freeDSP/freeDSP-aurora/ADDONS/AddOnB/KICAD/Board B/AddOnB.kicad_pcb

## KiCad design ADDONS/AddOnB/KICAD/Board B/AddOnB.kicad_pcb (2019-11-06)

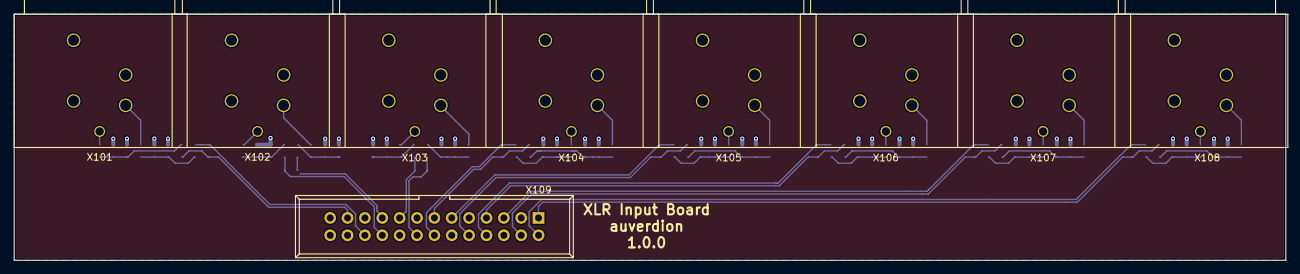
[picture p1: board ADDONS/AddOnB/KICAD/Board B/AddOnB.kicad_pcb from above]

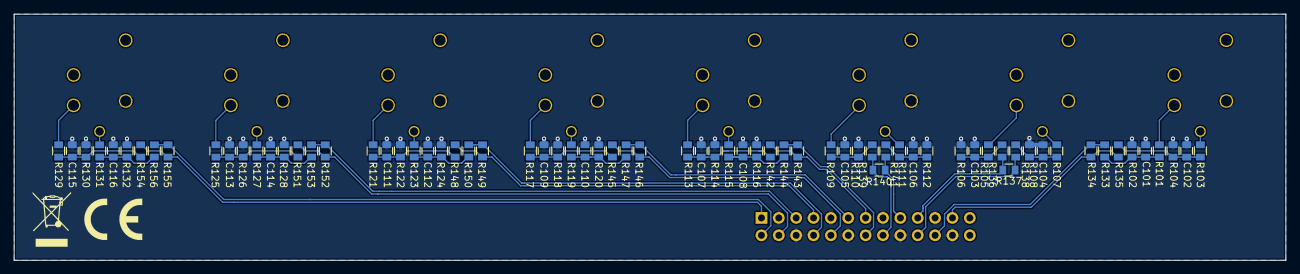
[picture p2: board ADDONS/AddOnB/KICAD/Board B/AddOnB.kicad_pcb from below]

Board: 2 copper layers, 186.0 x 36.0 mm, 81 parts (72 on the bottom side), 49 nets.

Parts:
C101, C102, C103, C104, C105, C106, C107, C108, C109, C110, C111, C112, C113, C114, C115, C116: CAP_100p_50V_C0G_NP0_0805; C0805-X7R
R101, R103, R105, R107, R109, R111, R113, R115, R117, R119, R121, R123, R125, R127, R129, R131: RES_100R_1%_0.25W_Thin_0805; C0805-RES
R102, R104, R106, R108, R110, R112, R114, R116, R118, R120, R122, R124, R126, R128, R130, R132: RES_100K_1%_0.125W_Thick_0805; C0805-RES
R133, R135, R136, R138, R139, R141, R142, R144, R145, R147, R148, R150, R151, R153, R154, R156: RES_7K87_0.5%_0.100W_Thin_0805; C0805-RES
R134, R137, R140, R143, R146, R149, R152, R155: RES_5K11_0.5%_0.100W_Thin_0805; C0805-RES
X101, X102, X103, X104, X105, X106, X107, X108: XLR3; NC3FAH
X109: CON_IDC26; IDC26

Connections:
/AIN1+: R133.2, R134.2, X109.22
/AIN1-: R134.1, R135.2, X109.23
/AIN2+: R136.2, R137.2, X109.19
/AIN2-: R137.1, R138.2, X109.20
/AIN3+: R139.2, R140.2, X109.16
/AIN3-: R140.1, R141.2, X109.17
/AIN4+: R142.2, R143.2, X109.13
/AIN4-: R143.1, R144.2, X109.14
/AIN5+: R145.2, R146.2, X109.10
/AIN5-: R146.1, R147.2, X109.11
/AIN6+: R148.2, R149.2, X109.7
/AIN6-: R149.1, R150.2, X109.8
/AIN7+: R151.2, R152.2, X109.4
/AIN7-: R152.1, R153.2, X109.5
/AIN8+: R154.2, R155.2, X109.1
/AIN8-: R155.1, R156.2, X109.2
GND: C101.2, C102.2, C103.2, C104.2, C105.2, C106.2, C107.2, C108.2, C109.2, C110.2, C111.2, C112.2, C113.2, C114.2, C115.2, C116.2, R102.1, R104.1, R106.1, R108.1, R110.1, R112.1, R114.1, R116.1, R118.1, R120.1, R122.1, R124.1, R126.1, R128.1, R130.1, R132.1, X101.1, X102.1, X103.1, X104.1, X105.1, X106.1, X107.1, X108.1, X109.3, X109.6, X109.9, X109.12, X109.15, X109.18, X109.21, X109.24
unnamed: C101.1, R101.2, R102.2, R133.1
unnamed: C102.1, R103.2, R104.2, R135.1
unnamed: C103.1, R105.2, R106.2, R136.1
unnamed: C104.1, R107.2, R108.2, R138.1
unnamed: C105.1, R109.2, R110.2, R139.1
unnamed: C106.1, R111.2, R112.2, R141.1
unnamed: C107.1, R113.2, R114.2, R142.1
unnamed: C108.1, R115.2, R116.2, R144.1
unnamed: C109.1, R117.2, R118.2, R145.1
unnamed: C110.1, R119.2, R120.2, R147.1
unnamed: C111.1, R121.2, R122.2, R148.1
unnamed: C112.1, R123.2, R124.2, R150.1
unnamed: C113.1, R125.2, R126.2, R151.1
unnamed: C114.1, R127.2, R128.2, R153.1
unnamed: C115.1, R129.2, R130.2, R154.1
unnamed: C116.1, R131.2, R132.2, R156.1
unnamed: R101.1, X101.2
unnamed: R103.1, X101.3
unnamed: R105.1, X102.2
unnamed: R107.1, X102.3
unnamed: R109.1, X103.2
unnamed: R111.1, X103.3
unnamed: R113.1, X104.2
unnamed: R115.1, X104.3
unnamed: R117.1, X105.2
unnamed: R119.1, X105.3
unnamed: R121.1, X106.2
unnamed: R123.1, X106.3
unnamed: R125.1, X107.2
unnamed: R127.1, X107.3
unnamed: R129.1, X108.2
unnamed: R131.1, X108.3
