freeDSP/freeDSP-aurora/ADDONS/AddOnB/KICAD/Board A/AddOnB.kicad_pcb

## KiCad design ADDONS/AddOnB/KICAD/Board A/AddOnB.kicad_pcb (2020-05-26)

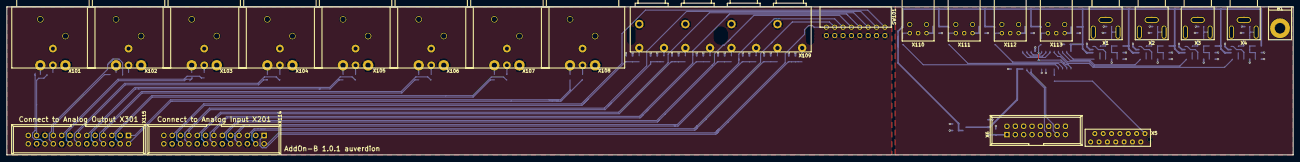
[picture p12: board ADDONS/AddOnB/KICAD/Board A/AddOnB.kicad_pcb from above]

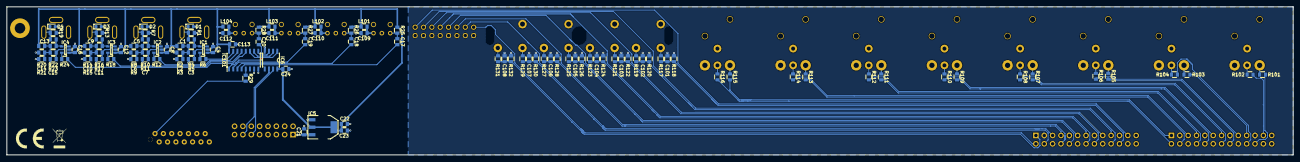
[picture p13: board ADDONS/AddOnB/KICAD/Board A/AddOnB.kicad_pcb from below]

Board: 2 copper layers, 391.0 x 45.0 mm, 136 parts (113 on the bottom side), 102 nets.

Parts:
B1: Montagewinkel
C1, C2, C3, C4, C5, C6, C7, C8, C9, C10, C11, C12, C13, C14, C15, C16, C22, C24, C109, C110, C111, C112, C113: CAP_100n_50V_X7R_0805; C0805-X7R
C17, C18, C19, C20: CAP_10n0_50V_X7R_0805; C0805-X7R
C21, C23: CAP_10u0_25V_X5R_0805; C0805-X7R
C101, C102, C103, C104, C105, C106, C107, C108: CAP_100p_50V_C0G_NP0_0805; C0805-X7R
D1, D2, D3, D4: PESD0603-240; D_0603_1608Metric
IC1, IC2, IC3, IC4: FIN1002; SOT23-5
IC5: IC_NCP1117LPST33; SOT223
IC6: PCA9536D; SOIC8_3.9x4.9mm_Pitch1.27mm
IC101: 74HC251; SOIC-16_3.9x9.9mm_P1.27mm
L101, L102, L103, L104: 47u0; C0805-X7R
R1, R7, R13, R19: RES_91R0_1%_0.125W_Thick_0805; C0805-RES
R2, R8, R14, R20: RES_820R_1%_0.125W_Thick_0805; C0805-RES
R3, R4, R5, R9, R10, R11, R15, R16, R17, R21, R22, R23: RES_470R_1%_0.125W_Thick_0805; C0805-RES
R6, R12, R18, R24, R29: RES_33R0_1%_0.125W_Thick_0805; C0805-RES
R25, R26, R27, R28: RES_10K0_1%_0.125W_Thick_0805; C0805-RES
R101, R102, R103, R104, R105, R106, R107, R108, R109, R110, R111, R112, R113, R114, R115, R116: RES_68R0_1%_0.125W_Thin_0805; C0805-RES
R117, R119, R121, R123, R125, R127, R129, R131: RES_100R_1%_0.25W_Thin_0805; C0805-RES
R118, R120, R122, R124, R126, R128, R130, R132: RES_220K_1%_0.125W_Thick_0805; C0805-RES
SW101: SW_DIP_x08; KAS2108E
X1, X2, X3, X4: RCA; PJRAN1X1U01AUX
X5: MicroMatch14; MM-14G
X6: HDR_02x08; IDC2x8_Pitch2.54mm
X101, X102, X103, X104, X105, X106, X107, X108: XLR3; NC3MAH
X109: CONN_RCA_02x04; PJRAS4X2U01
X110, X111, X112, X113: PLR135_T10
X114, X115: CON_IDC26; IDC26

Connections:
+3V3: C4.1, C8.1, C12.1, C16.1, C22.1, C23.1, C24.2, C113.2, IC1.1, IC2.1, IC3.1, IC4.1, IC5.2, IC5.4, IC6.8, IC101.16, L101.1, L102.1, L103.1, L104.1, R2.1, R8.1, R14.1, R20.1, R25.2, R26.2, R27.2, R28.2
/AIN1+: C101.1, R117.2, R118.2, X114.22
/AIN1-: SW101.1, X114.23
/AIN2+: C102.1, R119.2, R120.2, X114.19
/AIN2-: SW101.2, X114.20
/AIN3+: C103.1, R121.2, R122.2, X114.16
/AIN3-: SW101.3, X114.17
/AIN4+: C104.1, R123.2, R124.2, X114.13
/AIN4-: SW101.4, X114.14
/AIN5+: C105.1, R125.2, R126.2, X114.10
/AIN5-: SW101.5, X114.11
/AIN6+: C106.1, R127.2, R128.2, X114.7
/AIN6-: SW101.6, X114.8
/AIN7+: C107.1, R129.2, R130.2, X114.4
/AIN7-: SW101.7, X114.5
/AIN8+: C108.1, R131.2, R132.2, X114.1
/AIN8-: SW101.8, X114.2
/AOUT1+: R101.1, X115.22
/AOUT1-: R102.1, X115.23
/AOUT2+: R103.1, X115.19
/AOUT2-: R104.1, X115.20
/AOUT3+: R105.1, X115.16
/AOUT3-: R106.1, X115.17
/AOUT4+: R107.1, X115.13
/AOUT4-: R108.1, X115.14
/AOUT5+: R109.1, X115.10
/AOUT5-: R110.1, X115.11
/AOUT6+: R111.1, X115.7
/AOUT6-: R112.1, X115.8
/AOUT7+: R113.1, X115.4
/AOUT7-: R114.1, X115.5
/AOUT8+: R115.1, X115.1
/AOUT8-: R116.1, X115.2
/SCL: IC6.6, X6.13
/SDA: IC6.7, X6.11
/SPDIF_RX: R29.2, X5.1
GND: C2.2, C3.2, C4.2, C6.2, C7.2, C8.2, C10.2, C11.2, C12.2, C14.2, C15.2, C16.2, C21.2, C22.2, C23.2, C24.1, C101.2, C102.2, C103.2, C104.2, C105.2, C106.2, C107.2, C108.2, C109.2, C110.2, C111.2, C112.2, C113.1, D1.2, D2.2, D3.2, D4.2, IC1.2, IC2.2, IC3.2, IC4.2, IC5.1, IC6.4, IC101.7, IC101.8, R1.1, R3.1, R7.1, R9.1, R13.1, R15.1, R19.1, R21.1, R118.1, R120.1, R122.1, R124.1, R126.1, R128.1, R130.1, R132.1, SW101.9, SW101.10, SW101.11, SW101.12, SW101.13, SW101.14, SW101.15, SW101.16, X1.2, X2.2, X3.2, X4.2, X5.2, X5.4, X5.6, X5.8, X5.10, X5.12, X6.2, X6.4, X6.6, X6.8, X6.10, X6.12, X6.14, X6.16, X101.1, X102.1, X103.1, X104.1, X105.1, X106.1, X107.1, X108.1, X109.3A, X109.3B, X109.3C, X109.3D, X110.2, X111.2, X112.2, X113.2, X114.3, X114.6, X114.9, X114.12, X114.15, X114.18, X114.21, X114.24, X115.3, X115.6, X115.9, X115.12, X115.15, X115.18, X115.21, X115.24
unnamed: C1.1, D1.1, R1.2, X1.1
unnamed: C1.2, IC1.4, R4.2
unnamed: C2.1, R2.2, R3.2, R4.1, R5.1
unnamed: C3.1, IC1.3, R5.2
unnamed: C5.1, D2.1, R7.2, X2.1
unnamed: C5.2, IC2.4, R10.2
unnamed: C6.1, R8.2, R9.2, R10.1, R11.1
unnamed: C7.1, IC2.3, R11.2
unnamed: C9.1, D3.1, R13.2, X3.1
unnamed: C9.2, IC3.4, R16.2
unnamed: C10.1, R14.2, R15.2, R16.1, R17.1
unnamed: C11.1, IC3.3, R17.2
unnamed: C13.1, D4.1, R19.2, X4.1
unnamed: C13.2, IC4.4, R22.2
unnamed: C14.1, R20.2, R21.2, R22.1, R23.1
unnamed: C15.1, IC4.3, R23.2
unnamed: C17.1, R25.1, X110.3
unnamed: C17.2, IC101.4
unnamed: C18.1, R26.1, X111.3
unnamed: C18.2, IC101.3
unnamed: C19.1, R27.1, X112.3
unnamed: C19.2, IC101.2
unnamed: C20.1, R28.1, X113.3
unnamed: C20.2, IC101.1
unnamed: C109.1, L101.2, X110.1
unnamed: C110.1, L102.2, X111.1
unnamed: C111.1, L103.2, X112.1
unnamed: C112.1, L104.2, X113.1
unnamed: IC1.5, R6.1
unnamed: IC2.5, R12.1
unnamed: IC3.5, R18.1
unnamed: IC4.5, R24.1
unnamed: IC101.5, R29.1
unnamed: IC6.3, IC101.9
unnamed: IC6.2, IC101.10
unnamed: IC6.1, IC101.11
unnamed: IC101.12, R24.2
unnamed: IC101.13, R18.2
unnamed: IC101.14, R12.2
unnamed: IC101.15, R6.2
unnamed: R101.2, X101.2
unnamed: R102.2, X101.3
unnamed: R103.2, X102.2
unnamed: R104.2, X102.3
unnamed: R105.2, X103.2
unnamed: R106.2, X103.3
unnamed: R107.2, X104.2
unnamed: R108.2, X104.3
unnamed: R109.2, X105.2
unnamed: R110.2, X105.3
unnamed: R111.2, X106.2
unnamed: R112.2, X106.3
unnamed: R113.2, X107.2
unnamed: R114.2, X107.3
unnamed: R115.2, X108.2
unnamed: R116.2, X108.3
unnamed: R117.1, X109.2A
unnamed: R119.1, X109.1A
unnamed: R121.1, X109.2B
unnamed: R123.1, X109.1B
unnamed: R125.1, X109.2C
unnamed: R127.1, X109.1C
unnamed: R129.1, X109.2D
unnamed: R131.1, X109.1D
VPP: C21.1, IC5.3, X6.1
