freeDSP/freeDSP-aurora/ADDONS/AddOnC/KICAD/AddOnC.kicad_pcb

## KiCad design ADDONS/AddOnC/KICAD/AddOnC.kicad_pcb (2020-01-17)

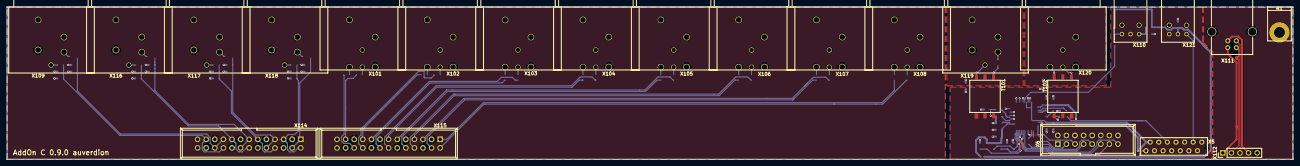
[picture p14: board AddOnC.kicad_pcb from above]

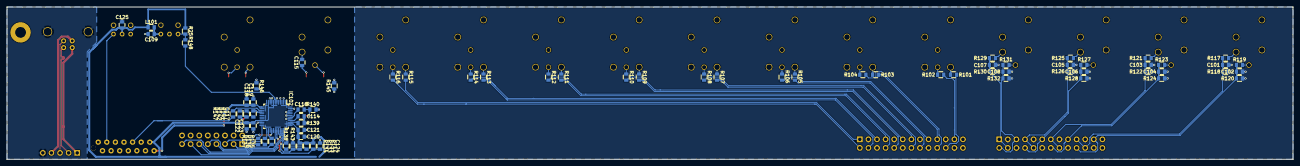
[picture p15: board AddOnC.kicad_pcb from below]

Board: 2 copper layers, 380.0 x 45.0 mm, 97 parts (72 on the bottom side), 89 nets.

Parts:
B1: Montagewinkel
C101, C102, C103, C104, C105, C106, C107, C108: CAP_100p_50V_C0G_NP0_0805; C0805-X7R
C109: CAP_100n_50V_X7R_0805; C0805-X7R
C114: 470n; C0805-X7R
C115, C116, C117, C119, C121, C123, C124, C125: 100n; C0805-X7R
C118, C120, C122: 10u0; C0805-X7R
IC102: AK4118AEQ; LQFP-48_7x7mm_P0.5mm
L101: 47u0; C0805-X7R
R25, R144: RES_10K0_1%_0.125W_Thick_0805; C0805-RES
R101, R102, R103, R104, R105, R106, R107, R108, R109, R110, R111, R112, R113, R114, R115, R116: RES_68R0_1%_0.125W_Thin_0805; C0805-RES
R117, R119, R121, R123, R125, R127, R129, R131: RES_100R_1%_0.25W_Thin_0805; C0805-RES
R118, R120, R122, R124, R126, R128, R130, R132: RES_100K_1%_0.125W_Thick_0805; C0805-RES
R133, R134: RES_DNP; C0805-RES
R135, R136, R137, R147: 33R0; C0805-RES
R138, R143, R145, R146: RES_0R00_1%_0.125W_Thick_0805; C0805-RES
R139: 10K0; C0805-RES
R140: 110R; C0805-RES
R141: 240R; C0805-RES
R142: 150R; C0805-RES
R148: 470R; C0805-RES
T101, T102: DA102; DA102MC
X5: MicroMatch14; MM-14G
X6: HDR_02x08; IDC2x8_Pitch2.54mm
X101, X102, X103, X104, X105, X106, X107, X108: XLR3; NC3MAH
X109, X116, X117, X118, X119: XLR3; NC3FAH
X110: PLR135_T10
X111: USB_B
X112: HDR_01x05; PinHeader_1x05_P2.54mm_Vertical
X114, X115: CON_IDC26; IDC26
X120: NC3MAH
X121: PLT133_T10W

Connections:
+3V3: C120.1, C121.1, C122.1, C123.1, C125.1, IC102.8, IC102.11, IC102.21, IC102.38, L101.1, R25.2, R133.2, R134.2, R144.2, X5.13, X121.2
+5V: C118.1, C119.1, IC102.13, X5.14
/AIN1+: C101.1, R117.2, R118.2, X114.19, X114.22
/AIN1-: C102.1, R119.2, R120.2, X114.20, X114.23
/AIN2+: C103.1, R121.2, R122.2, X114.13, X114.16
/AIN2-: C104.1, R123.2, R124.2, X114.14, X114.17
/AIN3+: C105.1, R125.2, R126.2, X114.7, X114.10
/AIN3-: C106.1, R127.2, R128.2, X114.8, X114.11
/AIN4+: C107.1, R129.2, R130.2, X114.1, X114.4
/AIN4-: C108.1, R131.2, R132.2, X114.2, X114.5
/AOUT1+: R101.1, X115.22
/AOUT1-: R102.1, X115.23
/AOUT2+: R103.1, X115.19
/AOUT2-: R104.1, X115.20
/AOUT3+: R105.1, X115.16
/AOUT3-: R106.1, X115.17
/AOUT4+: R107.1, X115.13
/AOUT4-: R108.1, X115.14
/AOUT5+: R109.1, X115.10
/AOUT5-: R110.1, X115.11
/AOUT6+: R111.1, X115.7
/AOUT6-: R112.1, X115.8
/AOUT7+: R113.1, X115.4
/AOUT7-: R114.1, X115.5
/AOUT8+: R115.1, X115.1
/AOUT8-: R116.1, X115.2
/BCLK:3: R135.2, X6.7
/D+: X111.3, X112.3
/D-: X111.2, X112.2
/LRCK:3: R137.1, X6.9
/MCLK: IC102.30, X6.15
/MDI:3: R136.1, X6.3
/MDO:3: IC102.28, X6.5
/OPTICAL_RX: R147.1, X5.9
/SCL: IC102.34, X6.13
/SDA: IC102.33, X6.11
/SPDIF_TX: X5.3, X121.1
/USB_SHIELD: X111.5, X112.5
GND: C101.2, C102.2, C103.2, C104.2, C105.2, C106.2, C107.2, C108.2, C109.2, C114.2, C118.2, C119.2, C120.2, C121.2, C122.2, C123.2, C124.2, C125.2, IC102.2, IC102.4, IC102.6, IC102.9, IC102.10, IC102.22, IC102.41, IC102.43, IC102.45, IC102.47, R118.1, R120.1, R122.1, R124.1, R126.1, R128.1, R130.1, R132.1, R138.1, R139.2, R140.2, R142.2, R143.1, R145.1, R146.1, T101.3, T102.2, X5.2, X5.4, X5.6, X5.8, X5.10, X5.12, X6.2, X6.4, X6.6, X6.8, X6.10, X6.12, X6.14, X6.16, X101.1, X102.1, X103.1, X104.1, X105.1, X106.1, X107.1, X108.1, X109.1, X110.2, X114.3, X114.6, X114.9, X114.12, X114.15, X114.18, X114.21, X114.24, X115.3, X115.6, X115.9, X115.12, X115.15, X115.18, X115.21, X115.24, X116.1, X117.1, X118.1, X121.3
unnamed: C109.1, L101.2, X110.1
unnamed: C114.1, IC102.40
unnamed: C115.1, T101.1
unnamed: C115.2, X119.2
unnamed: C116.1, IC102.42
unnamed: C116.2, R140.1, T101.4
unnamed: C117.1, R141.2
unnamed: C117.2, IC102.16
unnamed: C124.1, IC102.31, R144.1
unnamed: IC102.7, R148.1
unnamed: IC102.15, R147.2
unnamed: IC102.24, R137.2
unnamed: IC102.25, R136.2
unnamed: IC102.26, R135.1
unnamed: IC102.32, R134.1, R143.2
unnamed: IC102.35, R133.1, R138.2
unnamed: IC102.39, R139.1
unnamed: R101.2, X101.2
unnamed: R102.2, X101.3
unnamed: R103.2, X102.2
unnamed: R104.2, X102.3
unnamed: R105.2, X103.2
unnamed: R106.2, X103.3
unnamed: R107.2, X104.2
unnamed: R108.2, X104.3
unnamed: R109.2, X105.2
unnamed: R110.2, X105.3
unnamed: R111.2, X106.2
unnamed: R112.2, X106.3
unnamed: R113.2, X107.2
unnamed: R114.2, X107.3
unnamed: R115.2, X108.2
unnamed: R116.2, X108.3
unnamed: R117.1, X109.2
unnamed: R119.1, X109.3
unnamed: R121.1, X116.2
unnamed: R123.1, X116.3
unnamed: R125.1, X117.2
unnamed: R127.1, X117.3
unnamed: R129.1, X118.2
unnamed: R131.1, X118.3
unnamed: R141.1, R142.1, T102.1
unnamed: R145.2, X119.1
unnamed: R146.2, X120.1
unnamed: R25.1, R148.2, X110.3
unnamed: T101.2, X119.3
unnamed: T102.3, X120.3
unnamed: T102.4, X120.2
unnamed: X111.1, X112.1
unnamed: X111.4, X112.4
