freeDSP/freeDSP-aurora/ADDONS/AddOnA/KICAD/AddOnA.kicad_pcb

## KiCad design ADDONS/AddOnA/KICAD/AddOnA.kicad_pcb (2020-01-06)

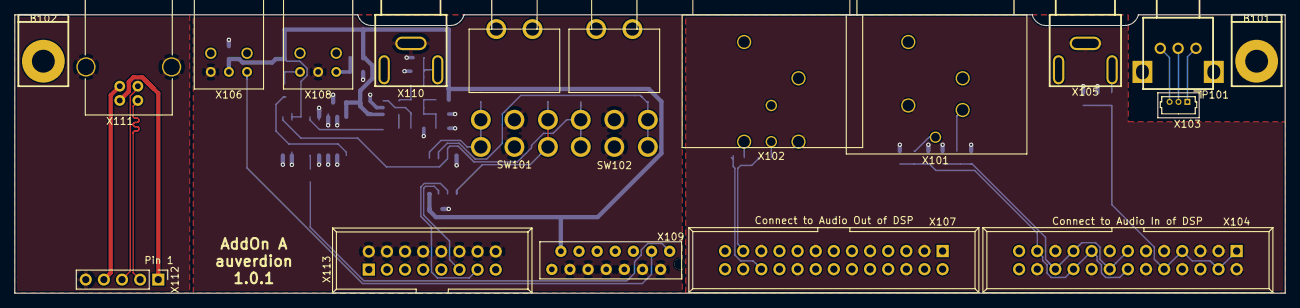
[picture p16: board AddOnA.kicad_pcb from above]

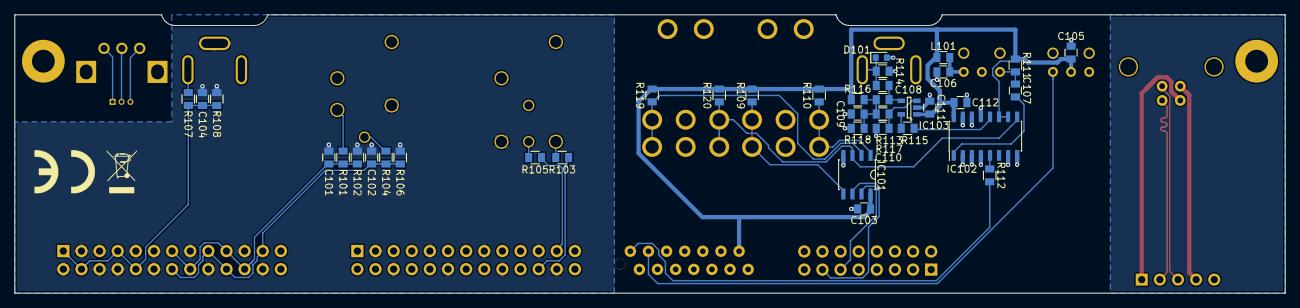
[picture p17: board AddOnA.kicad_pcb from below]

Board: 2 copper layers, 178.0 x 39.0 mm, 55 parts (37 on the bottom side), 38 nets.

Parts:
B101, B102: Montagewinkel
C101, C102, C104: CAP_100p_50V_C0G_NP0_0805; C0805-X7R
C103, C105, C106, C108, C109, C110, C111, C112: CAP_100n_50V_X7R_0805; C0805-X7R
C107: CAP_10n0_50V_X7R_0805; C0805-X7R
D101: PESD0603-240; D_0603_1608Metric
IC101: PCA9536D; SOIC8_3.9x4.9mm_Pitch1.27mm
IC102: 74HC251; SOIC-16_3.9x9.9mm_P1.27mm
IC103: FIN1002; SOT23-5
L101: 47u0; C0805-X7R
P101: 10K0; RK09K1110-20
R101, R104, R107: RES_100R_1%_0.25W_Thin_0805; C0805-RES
R102, R106: RES_100K_1%_0.125W_Thick_0805; C0805-RES
R103, R105: RES_68R0_1%_0.125W_Thin_0805; C0805-RES
R108: RES_220K_1%_0.125W_Thick_0805; C0805-RES
R109, R110, R119, R120: RES_47K0_1%_0.125W_Thick_0805; C0805-RES
R111: RES_10K0_1%_0.125W_Thick_0805; C0805-RES
R112, R115: RES_33R0_1%_0.125W_Thick_0805; C0805-RES
R113, R117, R118: RES_470R_1%_0.125W_Thick_0805; C0805-RES
R114: RES_91R0_1%_0.125W_Thick_0805; C0805-RES
R116: RES_820R_1%_0.125W_Thick_0805; C0805-RES
SW101, SW102: Switch_DPDT; GEMINI_A
X101: XLR3; NC3FAH
X102: XLR3; NC3MAH
X103: Conn_01x03; Molex_PicoBlade_530470310
X104, X107: CON_IDC26; IDC26
X105, X110: RCA; PJRAN1X1U01AUX
X106: PLT133_T10W
X108: PLR135_T10
X109: MicroMatch14; MM-14G
X111: CON_USB_B; USB_B
X112: HDR_01x05; PinHeader_1x05_P2.54mm_Vertical
X113: HDR_02x08; IDC2x8_Pitch2.54mm

Connections:
+3V3: C103.2, C105.2, C111.1, C112.2, IC101.8, IC102.10, IC102.11, IC102.16, IC103.1, L101.1, R109.2, R110.2, R111.2, R116.1, R119.2, R120.2, X106.2, X109.13
/AIN1+: C101.1, R101.2, R102.2, X104.13, X104.16, X104.19, X104.22
/AIN1-: C102.1, R104.2, R106.2, X104.14, X104.17, X104.20, X104.23
/AIN5+: C104.1, R107.2, R108.2, X104.1, X104.4, X104.7, X104.10
/AOUT1+: R103.1, X107.22
/AOUT1-: R105.1, X107.23
/D+: X111.3, X112.3
/D-: X111.2, X112.2
/DIGSEL:0: IC101.3, IC102.9, R120.1, SW102.3, SW102.6
/DIGSEL:1: IC101.2, R119.1, SW102.1, SW102.4
/DIG_LEFT: IC101.5, R109.1, SW101.1, SW101.4
/DIG_RIGHT: IC101.1, R110.1, SW101.3, SW101.6
/SCL: IC101.6, X113.13
/SDA: IC101.7, X113.11
/SPDIF_RX: R112.2, X109.1
/SPDIF_TX: X106.1, X109.3
GND: C101.2, C102.2, C103.1, C104.2, C105.1, C106.2, C109.2, C110.2, C111.2, C112.1, D101.2, IC101.4, IC102.2, IC102.3, IC102.4, IC102.7, IC102.8, IC102.13, IC102.14, IC102.15, IC103.2, R102.1, R106.1, R108.1, R114.1, R118.1, SW101.2, SW101.5, SW102.2, SW102.5, X101.1, X102.1, X104.2, X104.3, X104.5, X104.6, X104.8, X104.9, X104.11, X104.12, X104.15, X104.18, X104.21, X104.24, X105.2, X106.3, X107.3, X107.6, X107.9, X107.12, X107.15, X107.18, X107.21, X107.24, X108.2, X109.2, X109.4, X109.6, X109.8, X109.10, X109.12, X110.2, X113.2, X113.4, X113.6, X113.8, X113.10, X113.12, X113.14, X113.16
unnamed: C106.1, L101.2, X108.1
unnamed: C107.1, R111.1, X108.3
unnamed: C107.2, IC102.1
unnamed: C108.1, D101.1, R114.2, X110.1
unnamed: C108.2, IC103.4, R113.2
unnamed: C109.1, R113.1, R116.2, R117.1, R118.2
unnamed: C110.1, IC103.3, R117.2
unnamed: IC102.5, R112.1
unnamed: IC102.12, R115.2
unnamed: IC103.5, R115.1
unnamed: P101.1, X103.1
unnamed: P101.2, X103.2
unnamed: P101.3, X103.3
unnamed: R101.1, X101.2
unnamed: R103.2, X102.2
unnamed: R104.1, X101.3
unnamed: R105.2, X102.3
unnamed: R107.1, X105.1
unnamed: X111.1, X112.1
unnamed: X111.4, X112.4
unnamed: X111.5, X112.5
